Sgw32/C64-Pi1541-III-SMD/C64 Pi1541-III Module/C64 Pi1541-III Module.kicad_pcb

## KiCad design C64 Pi1541-III Module/C64 Pi1541-III Module.kicad_pcb (2025-03-15)

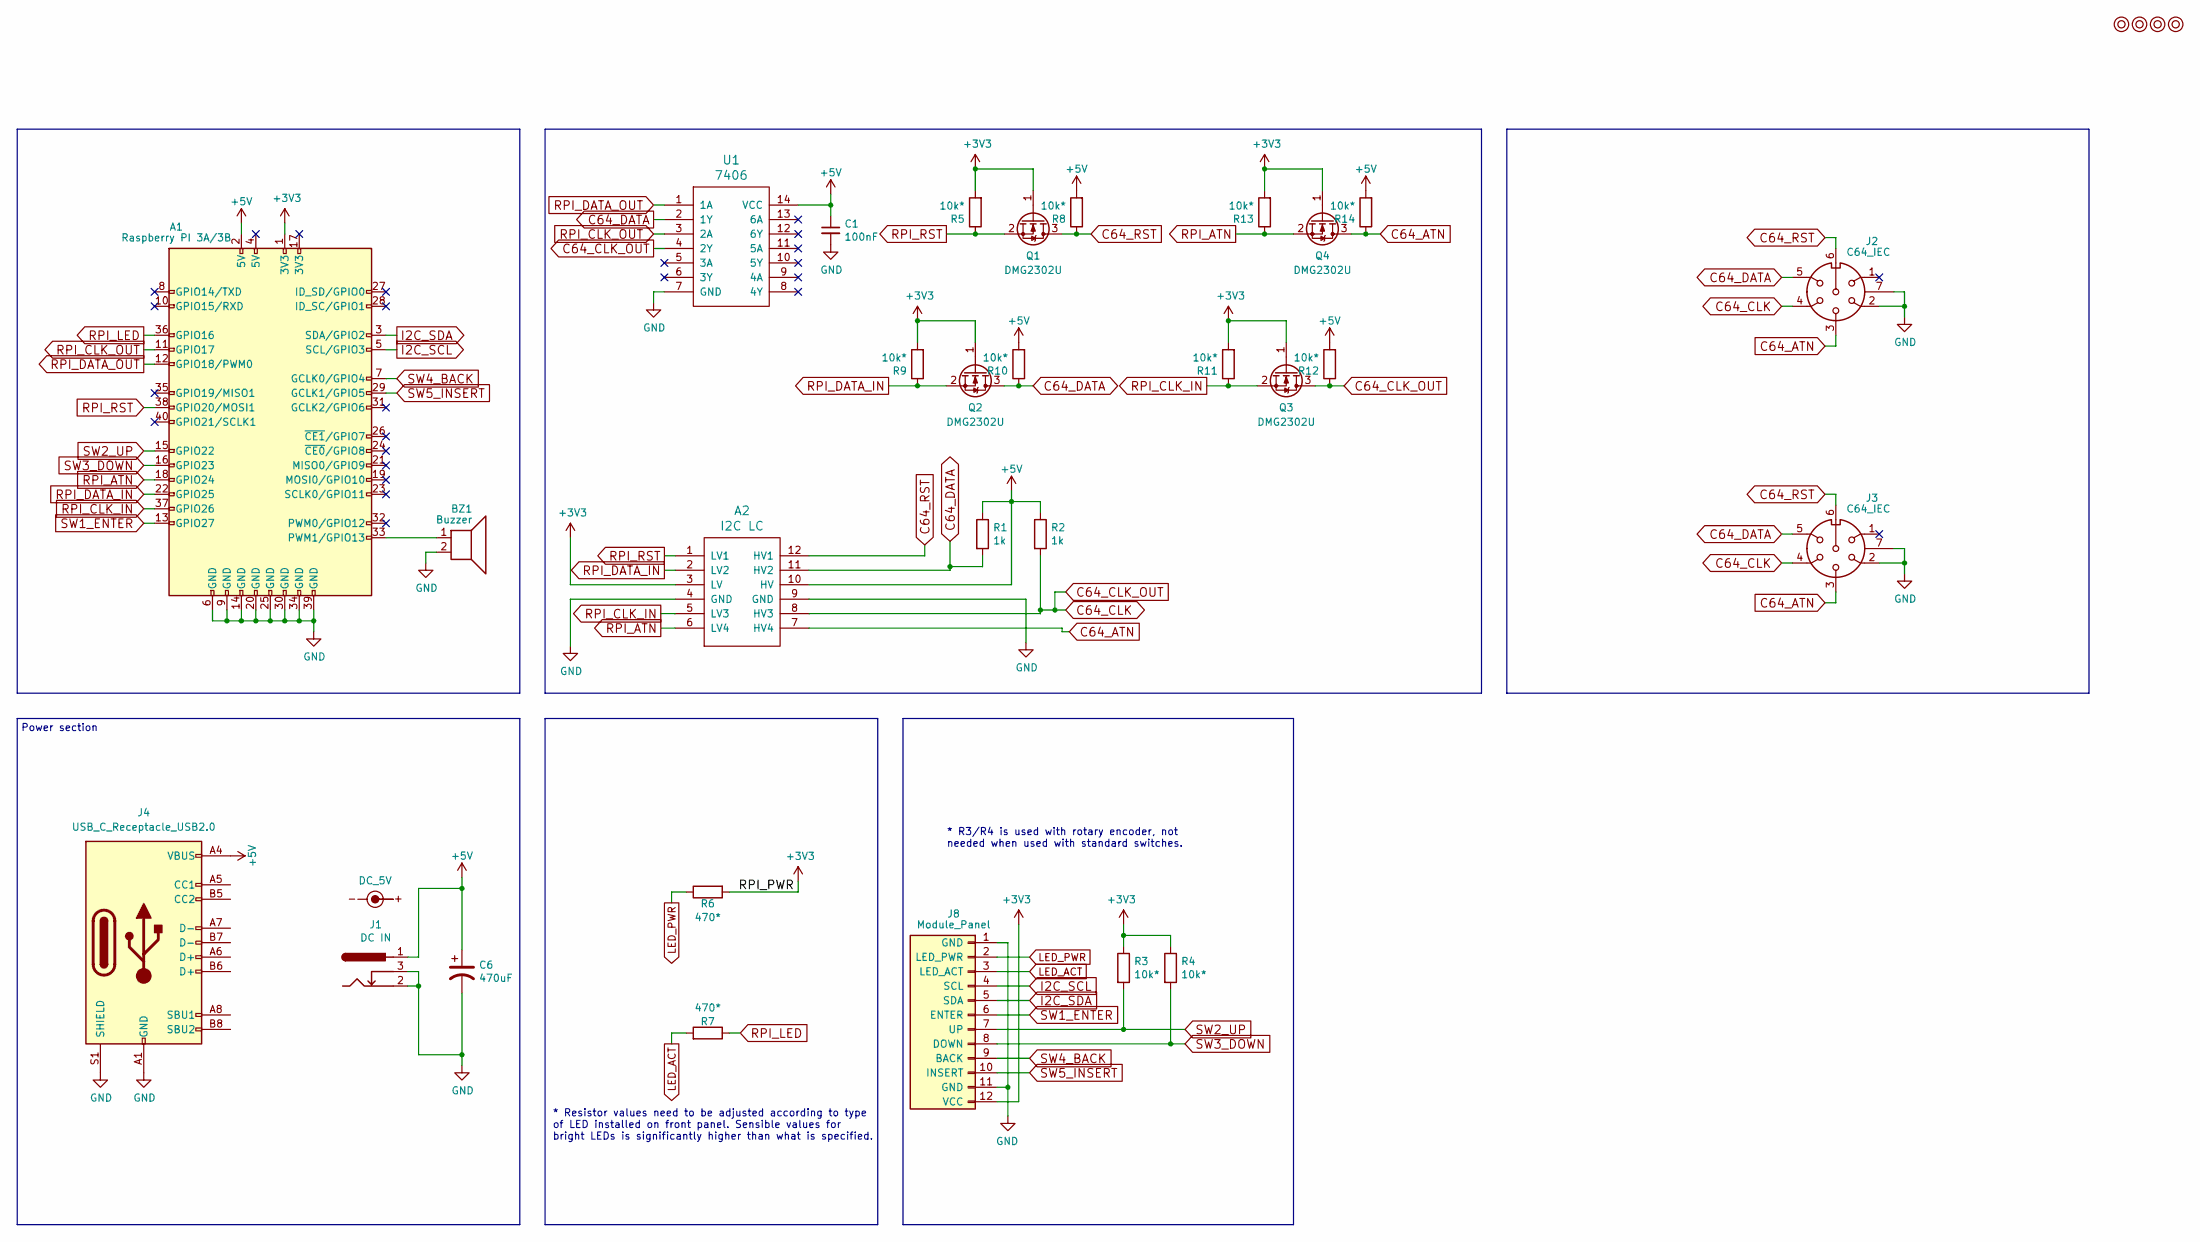
[picture p1: schematic C64 Pi1541-III Module.kicad_sch, PI1541-III Module]

Parts:
A1: Raspberry PI 3A/3B; Raspberry_Pi_3B_Socketed_THT_FaceDown_MountingHoles
A2: I2C LC; 4CH_I2C_Level_Converter
BZ1: Buzzer; Buzzer_12x9.5RM7.6
C1: 100nF; C_0805_2012Metric
C6: 470uF; CP_Elec_10x7.7
J1: DC IN; BarrelJack_CLIFF_FC681465S_SMT_Horizontal
J2, J3: C64_IEC; DIN6_IEC
J4: USB_C_Receptacle_USB2.0; USB_C_Receptacle_XKB_U262-16XN-4BVC11
J8: Module_Panel
M1, M2, M3, M4: Mounting; M3
Q1, Q2, Q3, Q4: DMG2302U; SOT-23
R1, R2: 1k; R_0805_2012Metric
R3, R4, R5, R8, R9, R10, R11, R12, R13, R14: 10k*; R_0805_2012Metric
R6, R7: 470*; R_0805_2012Metric
SYM1: DC_5V; PWR_Specification
U1: 7406; SO-14_3.9x8.65mm_P1.27mm

Connections:
+3V3: A1.1 (3V3), A2.3 (LV), J8.12 (VCC), Q1.1 (G), Q2.1 (G), Q3.1 (G), Q4.1 (G), R3.1, R4.1, R5.2, R6.2, R9.2, R11.2, R13.2
+5V: A1.2 (5V), A2.10 (HV), C1.1, C6.1, J1.1, J4.A4 (VBUS), J4.A9 (VBUS), J4.B4 (VBUS), J4.B9 (VBUS), R1.1, R2.1, R8.2, R10.2, R12.2, R14.2, U1.14 (VCC)
C64_ATN: A2.7 (HV4), J2.3, J3.3, Q4.3 (D), R14.1
C64_CLK: A2.8 (HV3), J2.4, J3.4, Q3.3 (D), R2.2, R12.1, U1.4 (2Y)
C64_DATA: A2.11 (HV2), J2.5, J3.5, Q2.3 (D), R1.2, R10.1, U1.2 (1Y)
C64_RST: A2.12 (HV1), J2.6, J3.6, Q1.3 (D), R8.1
GND: A1.6 (GND), A1.9 (GND), A1.14 (GND), A1.20 (GND), A1.25 (GND), A1.30 (GND), A1.34 (GND), A1.39 (GND), A2.4 (GND), A2.9 (GND), BZ1.2, C1.2, C6.2, J1.2, J1.3, J2.2, J2.7, J3.2, J3.7, J4.A1 (GND), J4.A12 (GND), J4.B1 (GND), J4.B12 (GND), J4.S1 (SHIELD), J8.1 (GND), J8.11 (GND), U1.7 (GND)
I2C_SCL: A1.5 (SCL/GPIO3), J8.4 (SCL)
I2C_SDA: A1.3 (SDA/GPIO2), J8.5 (SDA)
LED_ACT: J8.3 (LED_ACT), R7.2
LED_PWR: J8.2 (LED_PWR), R6.1
unnamed: A1.33 (PWM1/GPIO13), BZ1.1
RPI_ATN: A1.18 (GPIO24), A2.6 (LV4), Q4.2 (S), R13.1
RPI_CLK_IN: A1.37 (GPIO26), A2.5 (LV3), Q3.2 (S), R11.1
RPI_CLK_OUT: A1.11 (GPIO17), U1.3 (2A)
RPI_DATA_IN: A1.22 (GPIO25), A2.2 (LV2), Q2.2 (S), R9.1
RPI_DATA_OUT: A1.12 (GPIO18/PWM0), U1.1 (1A)
RPI_LED: A1.36 (GPIO16), R7.1
RPI_RST: A1.38 (GPIO20/MOSI1), A2.1 (LV1), Q1.2 (S), R5.1
SW1_ENTER: A1.13 (GPIO27), J8.6 (ENTER)
SW2_UP: A1.15 (GPIO22), J8.7 (UP), R3.2
SW3_DOWN: A1.16 (GPIO23), J8.8 (DOWN), R4.2
SW4_BACK: A1.7 (GCLK0/GPIO4), J8.9 (BACK)
SW5_INSERT: A1.29 (GCLK1/GPIO5), J8.10 (INSERT)

Notes on the sheet:
Power section
* R3/R4 is used with rotary encoder, not needed when used with standard switches.
* Resistor values need to be adjusted according to type of LED installed on front panel. Sensible values for bright LEDs is significantly higher than what is specified.

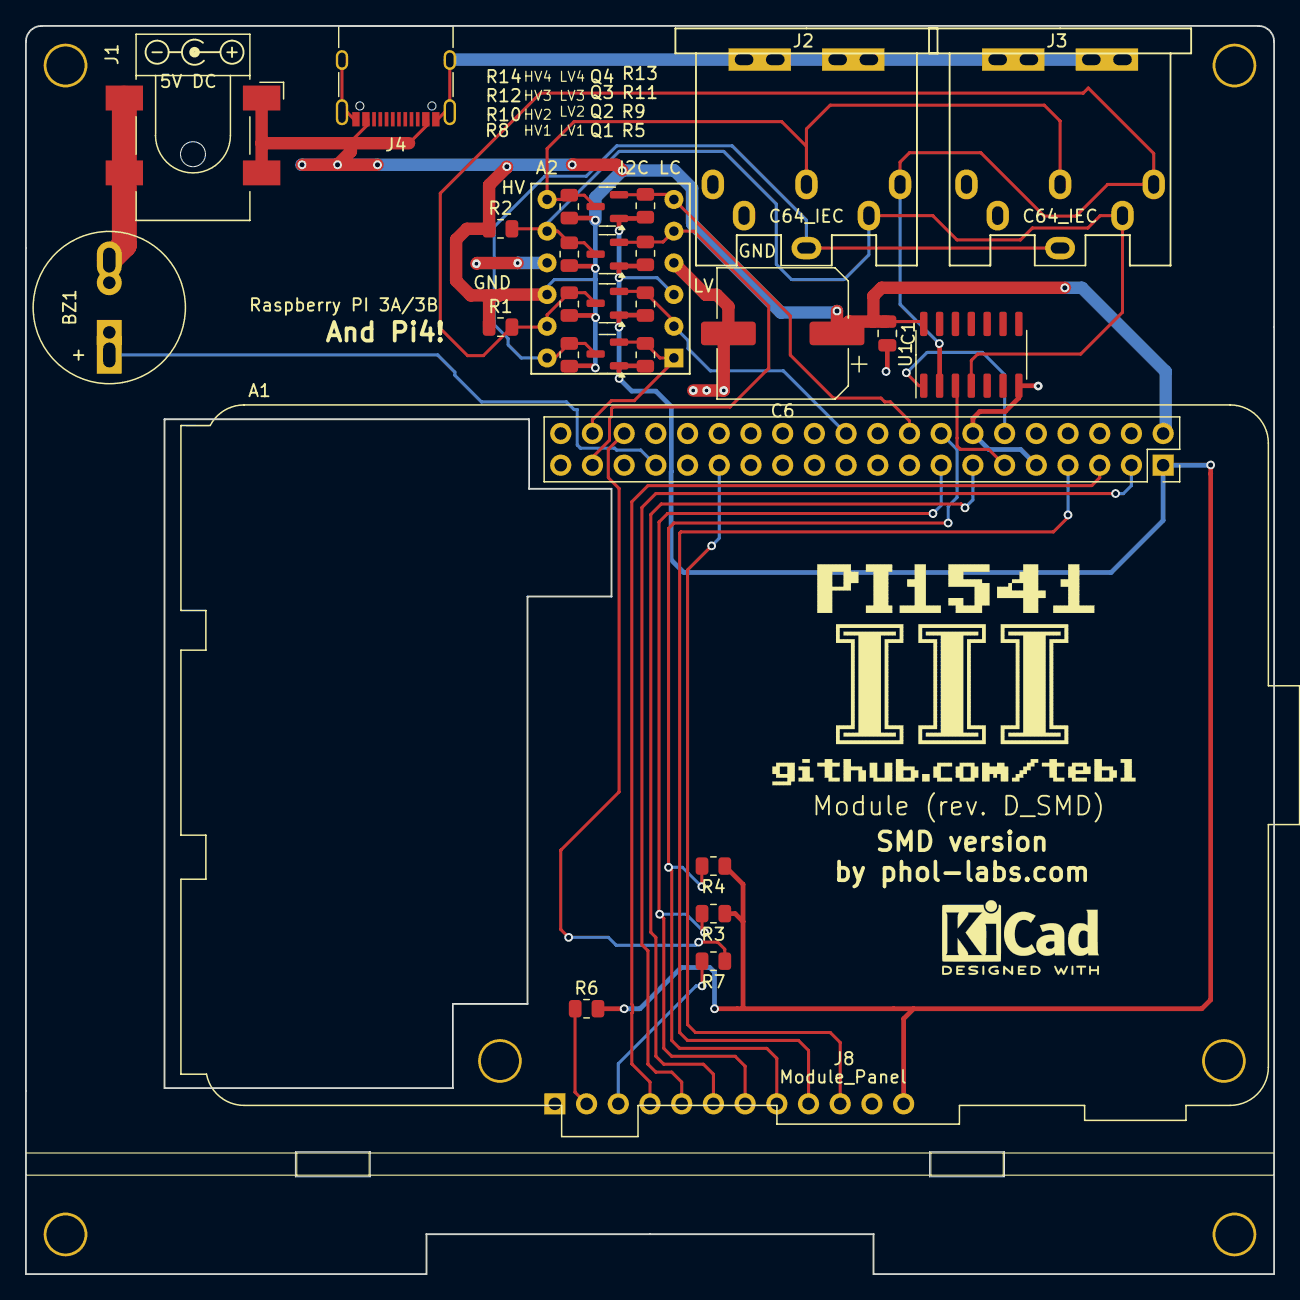
[picture p2: board C64 Pi1541-III Module.kicad_pcb from above]

Board: 2 copper layers, 100.0 x 100.0 mm, 35 parts (1 on the bottom side), 24 nets.

Other parts of the board:
Pi1541-drive: Pi1541-drive
