Sgw32/C64-Pi1541-III-SMD/C64 Pi1541-III Module Panel/C64 Pi1541-III Module Panel.kicad_pcb

## KiCad design C64 Pi1541-III Module Panel/C64 Pi1541-III Module Panel.kicad_pcb (2025-01-06)

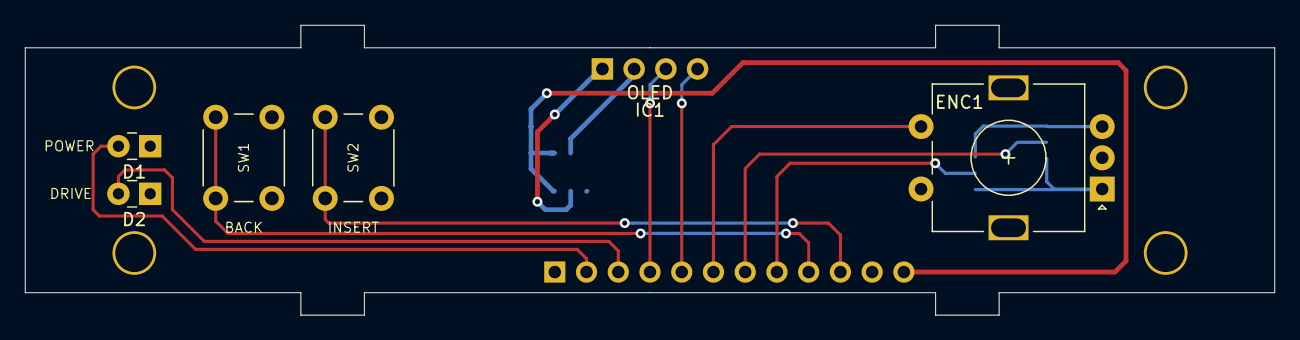
[picture p3: board C64 Pi1541-III Module Panel.kicad_pcb from above]

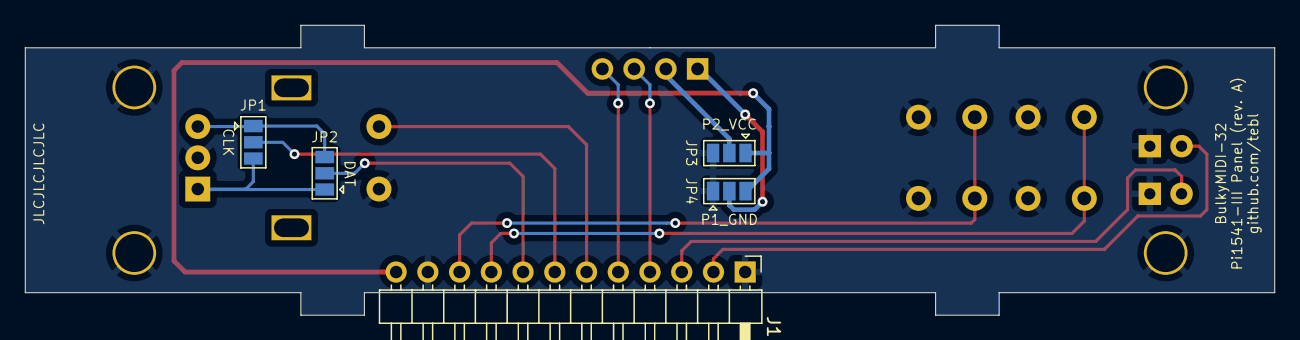
[picture p4: board C64 Pi1541-III Module Panel.kicad_pcb from below]

Board: 2 copper layers, 100.0 x 23.2 mm, 15 parts (5 on the bottom side), 15 nets.

Parts:
D1: POWER; LED_Rectangular_W3.0mm_H2.0mm
D2: DRIVE; LED_Rectangular_W3.0mm_H2.0mm
ENC1: Rotary_Encoder_Switch; RotaryEncoder_Alps_EC11E-Switch_Vertical_H20mm
IC1: OLED; 1.3_I2C_OLED_No_mounting
J1: Module Panel; PinHeader_1x12_P2.54mm_Horizontal
JP1: CLK; SolderJumper-3_P1.3mm_Open_Pad1.0x1.5mm
JP2: DAT; SolderJumper-3_P1.3mm_Open_Pad1.0x1.5mm
JP3: P1_GND; SolderJumper-3_P1.3mm_Open_Pad1.0x1.5mm
JP4: P2_VCC; SolderJumper-3_P1.3mm_Open_Pad1.0x1.5mm
M1, M2, M3, M4: Mounting_Pin; M3_pin
SW1: BACK; SW_PUSH_6mm
SW2: INSERT; SW_PUSH_6mm

Connections:
/A: ENC1.A, JP1.3, JP2.1
/B: ENC1.B, JP1.1, JP2.3
GND: D1.1, D2.1, ENC1.C, ENC1.S2, J1.1, J1.11, JP3.1, JP4.3, M1.1, M2.1, M3.1, M4.1, SW1.2, SW2.2
I2C_SCL: IC1.3, J1.4
I2C_SDA: IC1.4, J1.5
LED_ACT: D2.2, J1.3
LED_PWR: D1.2, J1.2
unnamed: IC1.1, JP3.2
unnamed: IC1.2, JP4.2
SW_BACK: J1.9, SW1.1
SW_DOWN: J1.8, JP2.2
SW_ENTER: ENC1.S1, J1.6
SW_INSERT: J1.10, SW2.1
SW_UP: J1.7, JP1.2
VCC: J1.12, JP3.3, JP4.1
